PedroPCardoso/processador-Lapido/(list of files, cad)

Other CAD files:
work/work/@banco_@registro/verilog.psm
work/work/@i@m@e@m/verilog.psm
work/work/@m@u@x1/verilog.psm
work/work/@registrador@flags/verilog.psm
work/work/@s@o@m@a@d@o@r/verilog.psm
work/work/@testador@flag/verilog.psm
work/work/@u@l@a/verilog.psm
work/work/@u@l@a_@t@b/verilog.psm
work/work/adder/verilog.psm
work/work/adder_tb/verilog.psm
work/work/bios/verilog.psm
work/work/clock@f@s@m/verilog.psm
work/work/fsm_using_single_always/verilog.psm
work/work/meio_somador/verilog.psm
work/work/mux/verilog.psm
work/work/programcounter/verilog.psm
work/work/register@file/verilog.psm
work/work/register@file_tb/verilog.psm
work/work/ripple_carry_adder/verilog.psm
work/work/sign_extend/verilog.psm
work/work/sign_extend_tb/verilog.psm
