PedroPCardoso/processador-Lapido/Verilog/instructions2.txt

00011111111111111111111111111111
00011111111111111111111111111111
01000010000000000000000000001010
01000001000000000000000000001111
00100001001000000001000000000000
00100011001100100000000000000000
00110010010000000010000000000000
00110101010101000000000000000000
00110011011000000000000000000000
00011111111111111111111111111111
00011111111111111111111111111111
00011111111111111111111111111111
00011111111111111111111111111111
