PedroPCardoso/processador-Lapido/Verilog/id_ex.v

module id_ex(clock,
	registerFileDataA_in,
	registerFileDataB_in,
	registerFileWrite_in,
	registerA_in,
	registerB_in,
	pcpp_in,
	extendedSignal_in,
	ALUOp_in,
	ALUSrc_in,
	memRead_in,
	memWrite_in,
	memToReg_in,
	regWrite_in,
	branch_in,
	jumpRegister_in,
	dataBRegisterFileSelector_in,
	registerFileDataA,
	registerFileDataB,
	registerFileWrite,
	registerA,
	registerB,
	pcpp,
	extendedSignal,
	ALUOp,
	ALUSrc,
	memRead,
	memWrite,
	memToReg,
	regWrite,
	branch,
	jumpRegister,
	dataBRegisterFileSelector
);

input clock;
input [31:0] registerFileDataA_in;
input [31:0] registerFileDataB_in;
input [3:0] registerFileWrite_in;
input [3:0] registerA_in;
input [3:0] registerB_in;
input [31:0] pcpp_in;
input [31:0] extendedSignal_in;
input [4:0] ALUOp_in;
input ALUSrc_in;
input memRead_in;
input memWrite_in;
input [1:0] memToReg_in;
input regWrite_in;
input branch_in;
input jumpRegister_in;
input dataBRegisterFileSelector_in;
output reg [31:0] registerFileDataA;
output reg [31:0] registerFileDataB;
output reg [3:0] registerFileWrite;
output reg [3:0] registerA;
output reg [3:0] registerB;
output reg [31:0] pcpp;
output reg [31:0] extendedSignal;
output reg [4:0] ALUOp;
output reg ALUSrc;
output reg memRead;
output reg memWrite;
output reg [1:0] memToReg;
output reg regWrite;
output reg branch;
output reg jumpRegister;
output reg dataBRegisterFileSelector;

always @(negedge clock) begin
	registerFileDataA = registerFileDataA_in;
	registerFileDataB = registerFileDataB_in;
	registerFileWrite = registerFileWrite_in;
	registerA = registerA_in;
	registerB = registerB_in;
	pcpp = pcpp_in;
	extendedSignal = extendedSignal_in;
	ALUOp = ALUOp_in;
	ALUSrc = ALUSrc_in;
	memRead = memRead_in;
	memWrite = memWrite_in;
	memToReg = memToReg_in;
	regWrite = regWrite_in;
	branch = branch_in;
	jumpRegister = jumpRegister_in;
	dataBRegisterFileSelector = dataBRegisterFileSelector_in;
end

endmodule
