PedroPCardoso/processador-Lapido/work/work/adder/_primary.vhd

library verilog;
use verilog.vl_types.all;
entity adder is
    port(
        dataA           : in     vl_logic_vector(31 downto 0);
        result          : out    vl_logic_vector(31 downto 0)
    );
end adder;
