PedroPCardoso/processador-Lapido/work/work/@s@o@m@a@d@o@r/_primary.vhd

library verilog;
use verilog.vl_types.all;
entity SOMADOR is
    port(
        Soma            : out    vl_logic;
        Cout            : out    vl_logic;
        A               : in     vl_logic;
        B               : in     vl_logic;
        Cin             : in     vl_logic
    );
end SOMADOR;
