PedroPCardoso/processador-Lapido/work/work/@i@m@e@m/_primary.vhd

library verilog;
use verilog.vl_types.all;
entity IMEM is
    port(
        address         : in     vl_logic_vector(31 downto 0);
        instruction     : out    vl_logic_vector(31 downto 0)
    );
end IMEM;
