PedroPCardoso/processador-Lapido/work/work/sign_extend/_primary.vhd

library verilog;
use verilog.vl_types.all;
entity sign_extend is
    port(
        extend          : in     vl_logic_vector(15 downto 0);
        extended        : out    vl_logic_vector(31 downto 0)
    );
end sign_extend;
