PedroPCardoso/processador-Lapido/work/work/@m@u@x1/_primary.vhd

library verilog;
use verilog.vl_types.all;
entity MUX1 is
    port(
        A               : in     vl_logic;
        B               : in     vl_logic;
        S               : in     vl_logic;
        X               : out    vl_logic
    );
end MUX1;
