PedroPCardoso/processador-Lapido/(commit log)

2015-12-08 Codigos auxiliares - Decodificadores de binario descimal e vice e versa
2015-12-08 Codigos auxiliares - Decodificadores de binario decimal e vice e versa
2015-12-19 Implementação do Instruction Decoding ainda sem o extensor de sinal
2015-12-20 Implementação da etapa "Execute" para instrução "add"
2015-12-20 Write Back implementado para escrita em registrador
2015-12-21 Início da implementação operação de subtração na ULA
2015-12-21 Implementação operacional de ULA para instruções "negA"
2015-12-21 Implementação da operação de ULA "or"
2015-12-21 Implementação da operação de ULA "and"
2015-12-21 Implementação da operação de ULA "shiftl"
2015-12-21 Processador funcionando para uma sequência de instruções; Cada ciclo de clock corresponde a uma vez que a tecla "enter" é pressionada
2015-12-22 Montador,identificando as funcoes aritmeticas, e colocando o op num arquivo, ainda não consegui separar os registradores, e e nem tratar os jumps e dividir os dados de pseg e dseg.
2015-12-22 Inclusão de operação constante "lch"
2016-02-11 Codigos Meta1 em verilog, ULA e Banco de Registradores
2016-02-15 Inclusão de: - contador de programa; - extensor de sinal; - bios (início)
2016-02-15 Incrementando Testes e criando banco de registradores !
    [verilog.psm]
2016-02-16 Extensor de sinal + teste bench
2016-02-17 Teste Bench da ULA
    Funcionando +/-
    [verilog.psm]
2016-02-17 Algumas mudanças no banco de registrador e no extensor de Sinal.
    Ambos estao passando no teste de compilacão do model sim, mas o banco
    ainda há mt warnings e precisa de modificaçoes .
2016-02-18 Mudancas no sign extend e no seu tb e na ula tb.
    [verilog.psm]
2016-02-18 mizera de maquina de estados nao funfaaa !!!!
    Add alguns testes na ula tb
    [verilog.psm]
2016-02-18 Teste de Extensor pronto !
    [verilog.psm]
2016-02-21 Memoria de Instrução !
    Desenvolvendo o TB ainda.
    [verilog.psm]
2016-02-22 Incrementando ULA_tb para teste com todas as instruções da ULA - Não funcionado para várias instruções. Não sei se problema é na ULA ou no TB
    [ULA_TB.v]
2016-02-22 Bug da ULA corrigido.
    [ULA.v]
2016-02-23 ULA TB #semidone
    Falta o LSL e ASR
    [verilog.psm]
2016-02-23 Adição de lsl e asr na ULA e respectivos testes
2016-02-24 Registrador de Flags e Testador de Flags
    add código do Registrador de Flags e Testador de Flags
2016-02-25 Banco_ula
    Teste de Integração ( Imcompleto !)
2016-02-29 Divisor de clock
2016-03-01 Início da integração dos módulos que participam do IF; Adição de memória; Adição da bios.
2016-03-08 Integração dos módulos para IF - Ainda falta a sincronização de tempo com a bios e inclusão do mux
2016-03-09 Integração dos módulos que participam do IF; Mux alterado; IF funcionando
2016-03-09 Inclusão de teste para o Banco de Registradores
2016-03-12 Mudanças no adder
    Soma bit a bit, com saida de carry.
    [verilog.psm]
2016-03-12 Mudanças na ula ! Coloquei o ccodigo de que são operações aritmetica antes do codigo do op
2016-03-19 Adição do registrador de pipeline if_id; Integração dos componentes do IF + if_id + register file; Remoção das mudanças do adder que deveriam estar na ULA; Alterações na bios para interação com a mem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
2016-03-19 Ajustes na sincronização de sinais na inicialização dos componentes após a parada da bios; Adição do registrador de pipeline id_ex
2016-03-21 Inclusão de unidade de controle; Inclusão do opcode da ULA para o registrador de pipeline id_ex; Integração dos módulos do estágio EX e adição ao pipeline; Unidade de controle enviando sinais para in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
2016-03-21 Adição do registrador de pipeline ex_mem e integração ao restante do processador; Repasse de sinais da unidade de controle até o estágio MEM
2016-03-21 Adição da memória de dados já funcionando em pipeline
2016-03-21 Adição do registrador de pipeline mem_wb; Repasse do sinal de controle memToReg em todos os estágios
2016-03-21 Write back funcionando; obedecendo à UC e escrevendo no bloco de registradores
2016-03-22 Adição das ligações e envio de sinais necessários para a execução da instrução STORE; Pipeline testado e funcionando para LOAD e STORE; Correção da ULA para funcionamento a partir do clock.
2016-03-22 Suporte à execução de todas as instruções que envolvem a ULA; Controle de sinais adicionados a todos os estágios do pipeline para controle de instruções que envolvem a ULA;
2016-03-22 Adição de suporte à execução de instruções que envolvem o uso de constantes
2016-03-22 Adição de suporte à execução de instruções do tipo NOP
2016-03-23 Gerenciamento dos sinais das emitidos pela UC para instruções que envolvem a ULA;
2016-03-23 Adição de mux de controle da entrada B do register file que possibilita transformar o endereço do registrador de WB em RB; Controle do register file passado para a UC; Correção na execução da instruç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
2016-03-23 Preparação do processador para suporte à execução de instruções de transferência de controle; UC enviando sinais para execução de beq; Mux do IF conectado com o sinal extendo e com PC++;
2016-03-23 Transferência de controle funcionando
2016-03-24 Multiplexadores tri-state para o Write Back
2016-03-24 Todas instruções de controle funcionando; Jal e Jr adicionados; Mux tri-state do WB selecionando ULA, memória e PC++; Mux adicionado ao EX para escolher entre jr e demais instruções de controle.
2016-03-26 Detectando Overflow ULA
    [verilog.psm]
2016-03-26 Hazard Detection Unit finalizada e integrada ao processador; Stall funcionando; Correção das alterações indevidas feitas na control no último commit
    [HDU.v, control.v, main.v, mux15bits.v]
2016-03-28 Detecção de Overflow e Carry ( ULA)
    #justnow
2016-03-28 Hazard de controle resolvido
2016-03-29 Extensor de Sinal. Diferenciando LCH e LCL.
2016-03-29 Ula com a entrada de clock .
2016-03-30 Atribuições para LCH e LCL .
2016-03-30 Extensor de sinal combinacional (não pode ser sequencial) com 3 modos de operação e respectivo testbench
2016-03-30 Voltando os opcodes da ULA para suporte aos saltos
2016-03-30 Processador executando LCL e LCH; Nova ULA já integrada ao processador; Controles adicionados para lcl e lch; Correção do opcode para sinal estendido
2016-03-30 Passagem de controle da bios sintetizável
2016-04-01 Correção do opcode da ULA para o offset do jump e da passagem do controle da bios
2016-04-02 Ajustes nos sinais de controle; Preparação da unidade de controle para o envio dos sinais de jt.cond e jf.cond
2016-04-04 Correção do bug do bloco de registradores
    [registerFile.v]
2016-04-07 Montador
    Falta fazer a parte de add as constante em algumas instruções, mas
    travei nisso.
    O montador gera dois arquivos, um com os dados para a memoria outra com
    instruções
2016-04-09 Ajuste na quantidade de registradores
2016-04-09 Correção da Forwarding Unit para não antecipar dados quando o campo de constante for usado
